s-ksattra/ESP32-P4-Motherboard/esp32-based-motherboard.pdf

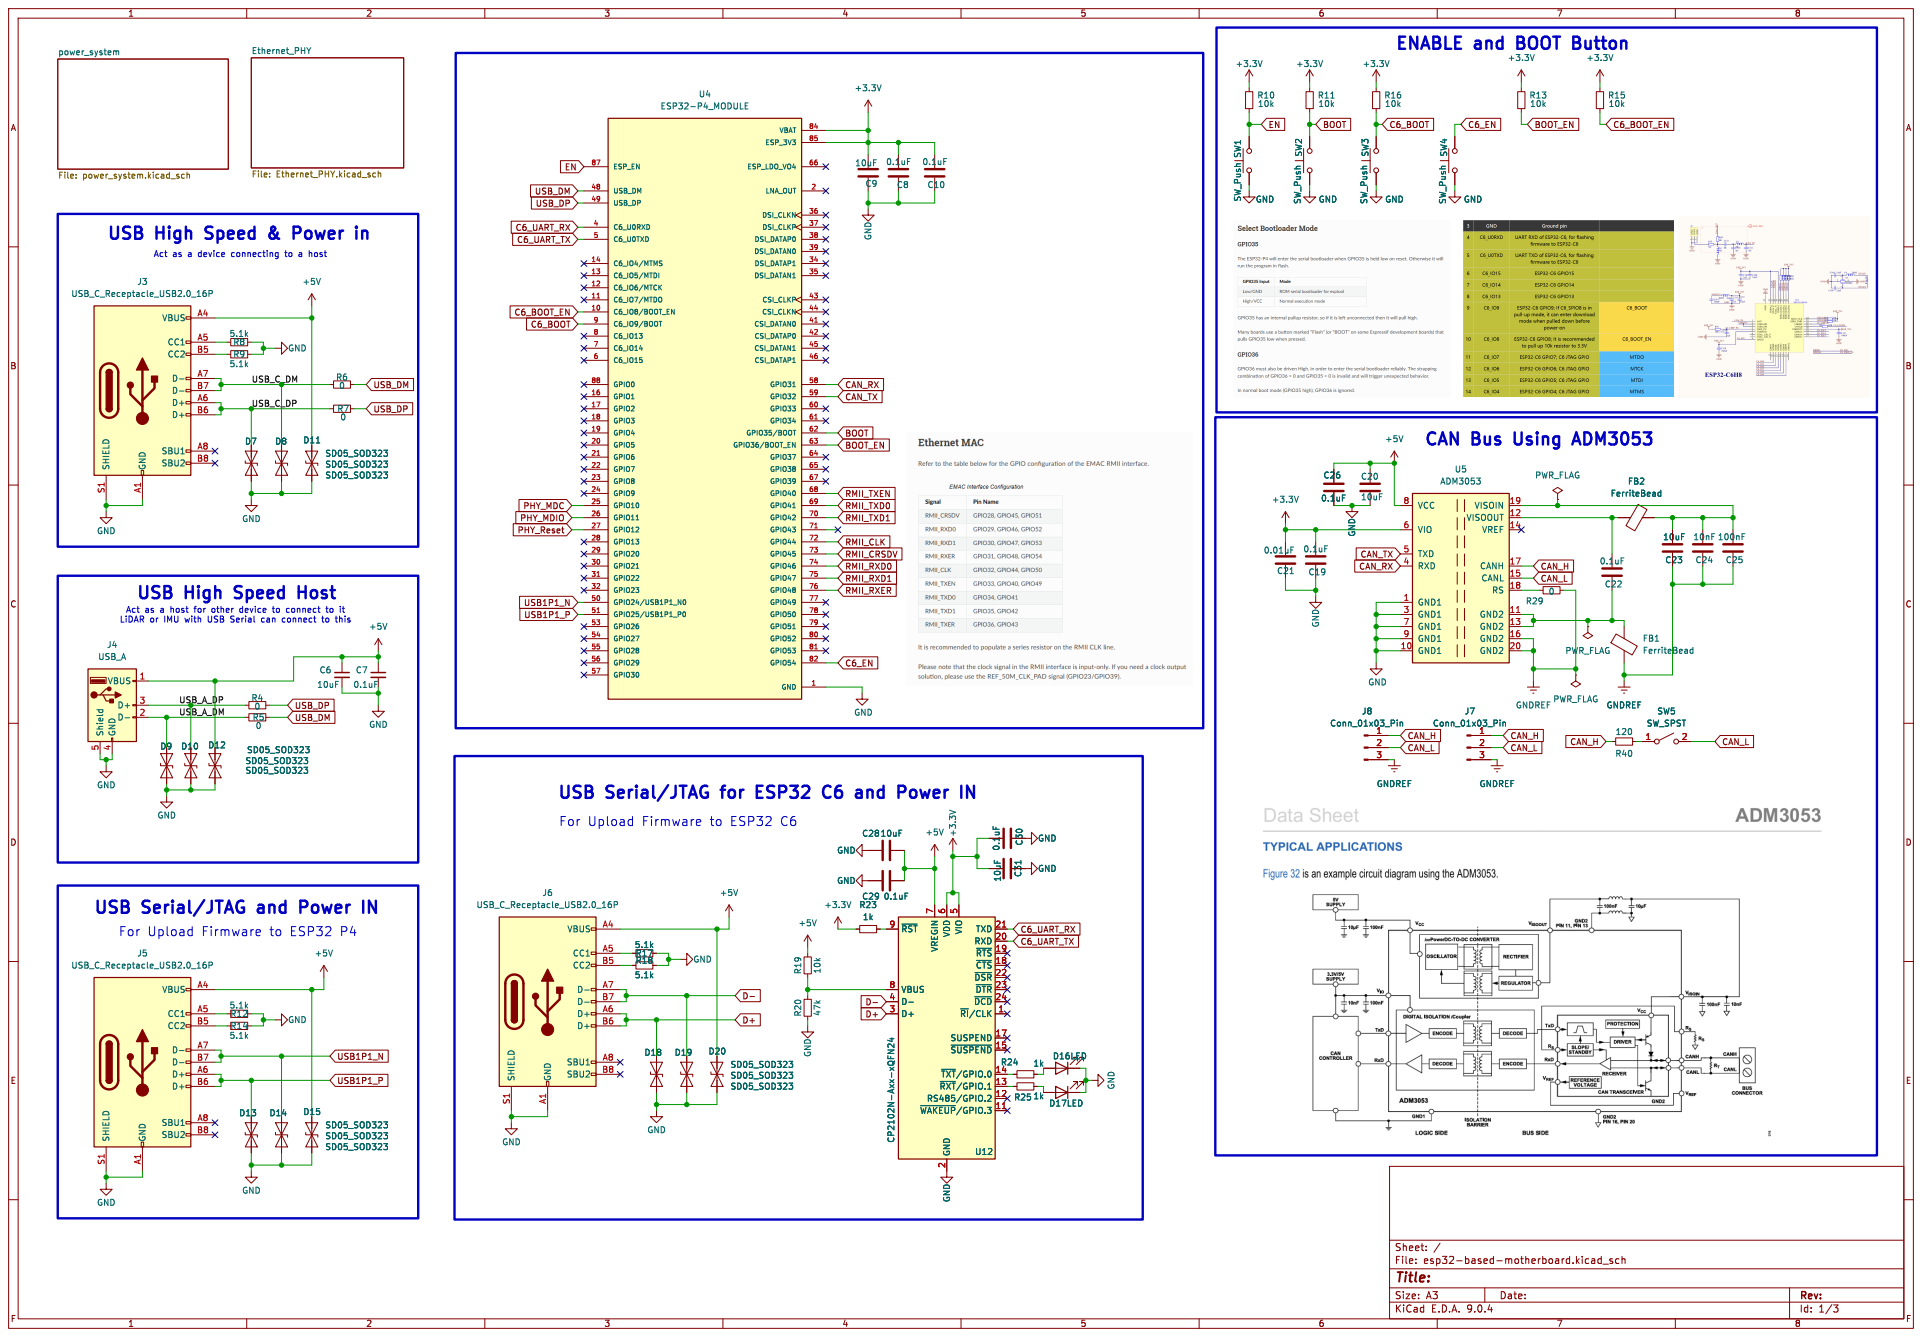
[picture p1: page 1]

ENABLE and BOOT Button

USB High Speed & Power in

For Upload Firmware to ESP32 C6

For Upload Firmware to ESP32 P4

Id: 1/3 Title: File: esp32-based-motherboard.kicad_sch Sheet: /

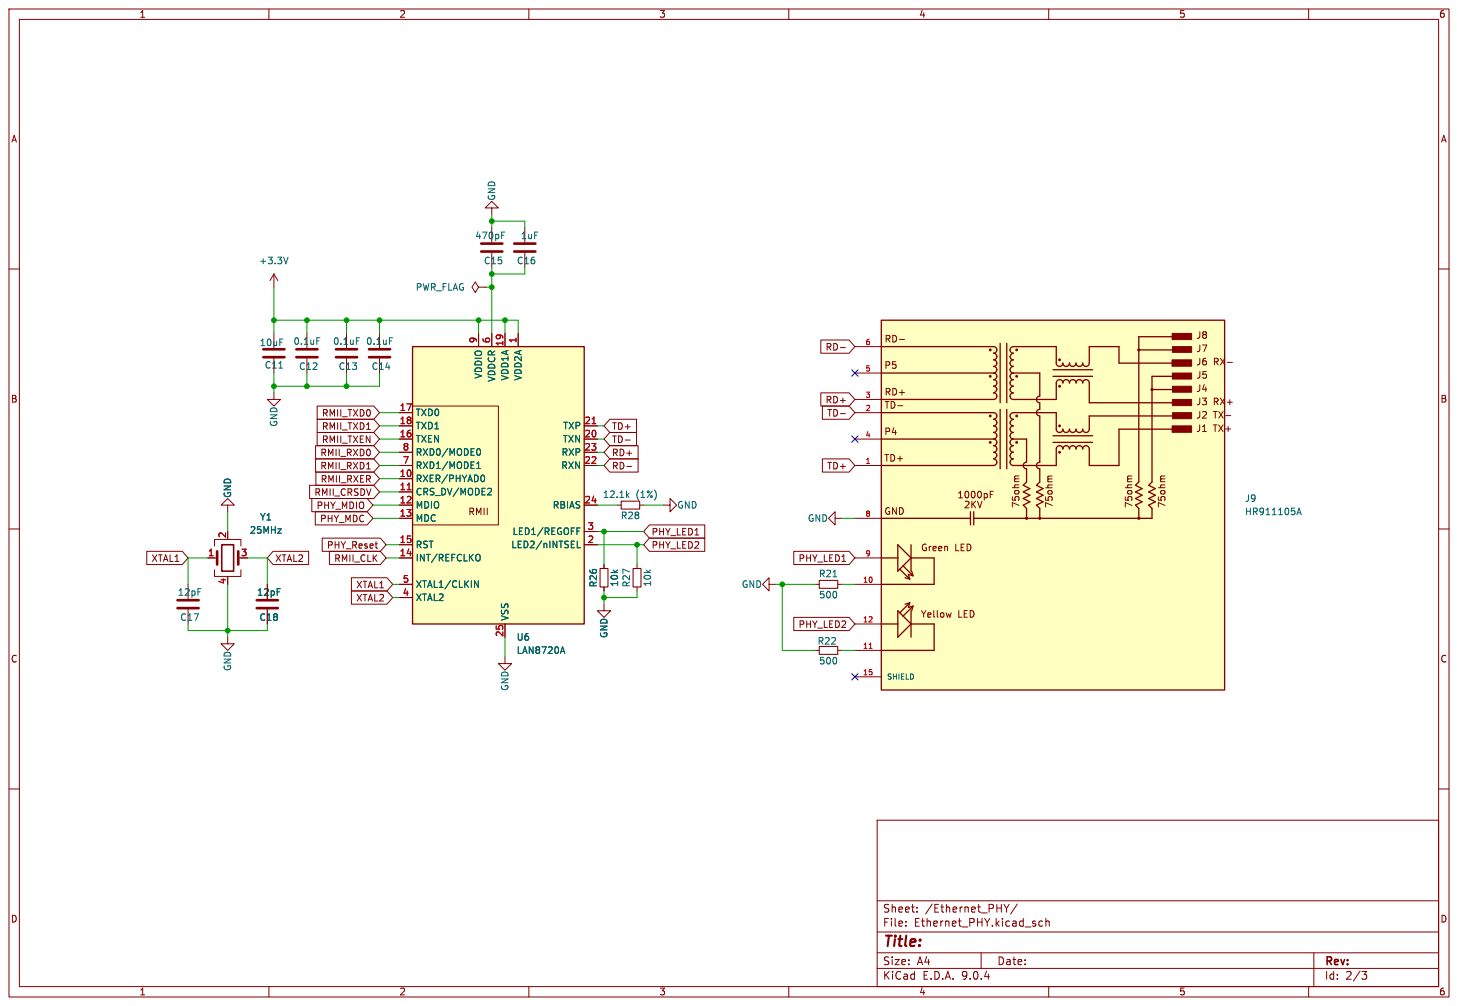
[picture p2: page 2]

1 TXP 21 TXN 20 RXP 23 RXN 22 RBIAS 24

Id: 2/3 Title: File: Ethernet_PHY.kicad_sch Sheet: /Ethernet_PHY/ C18

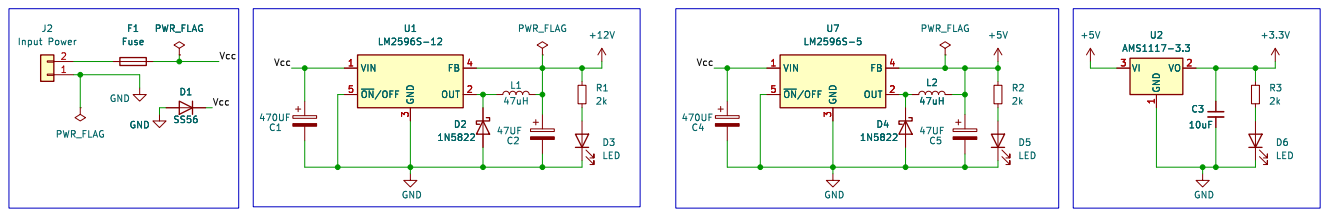
[picture p3: page 3]

1 VO 2 U2 AMS1117-3.3 Vcc Vcc Vcc Vcc F1 PWR_FLAG
Fuse GND

Id: 3/3 Title: File: power_system.kicad_sch Sheet: /power_system/
