s-ksattra/ESP32-P4-Motherboard/esp32-based-motherboard.kicad_pcb

## KiCad design esp32-based-motherboard.kicad_pcb (2026-08-06)

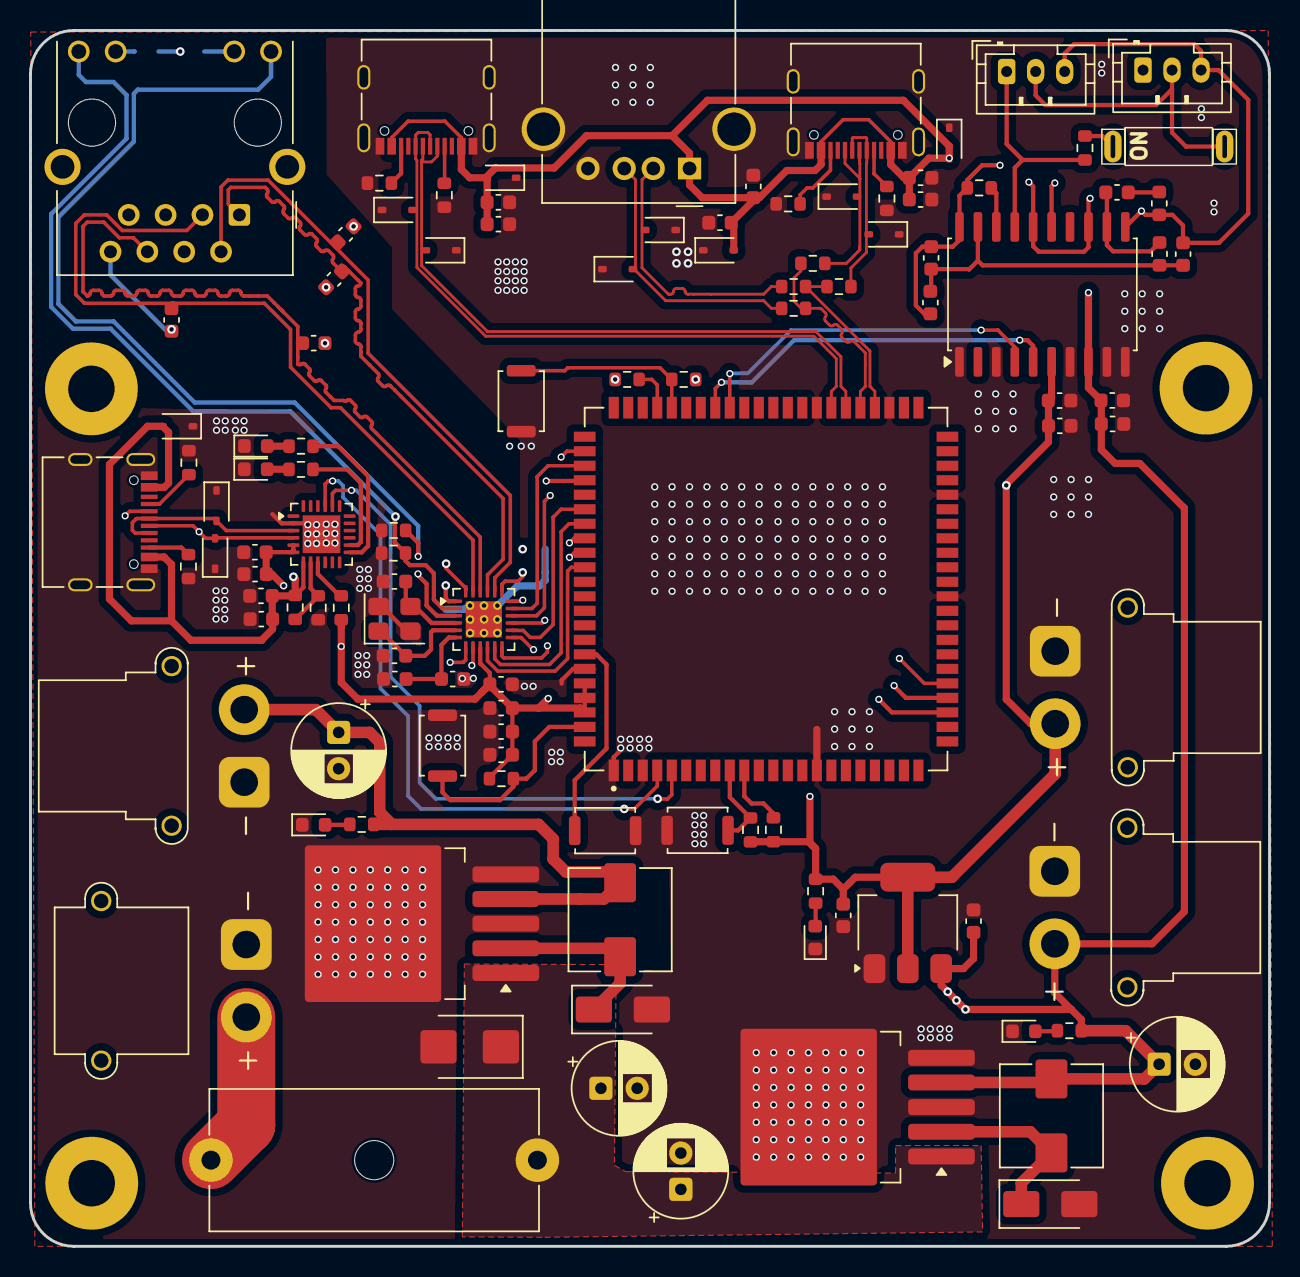
[picture p4: board esp32-based-motherboard.kicad_pcb from above]

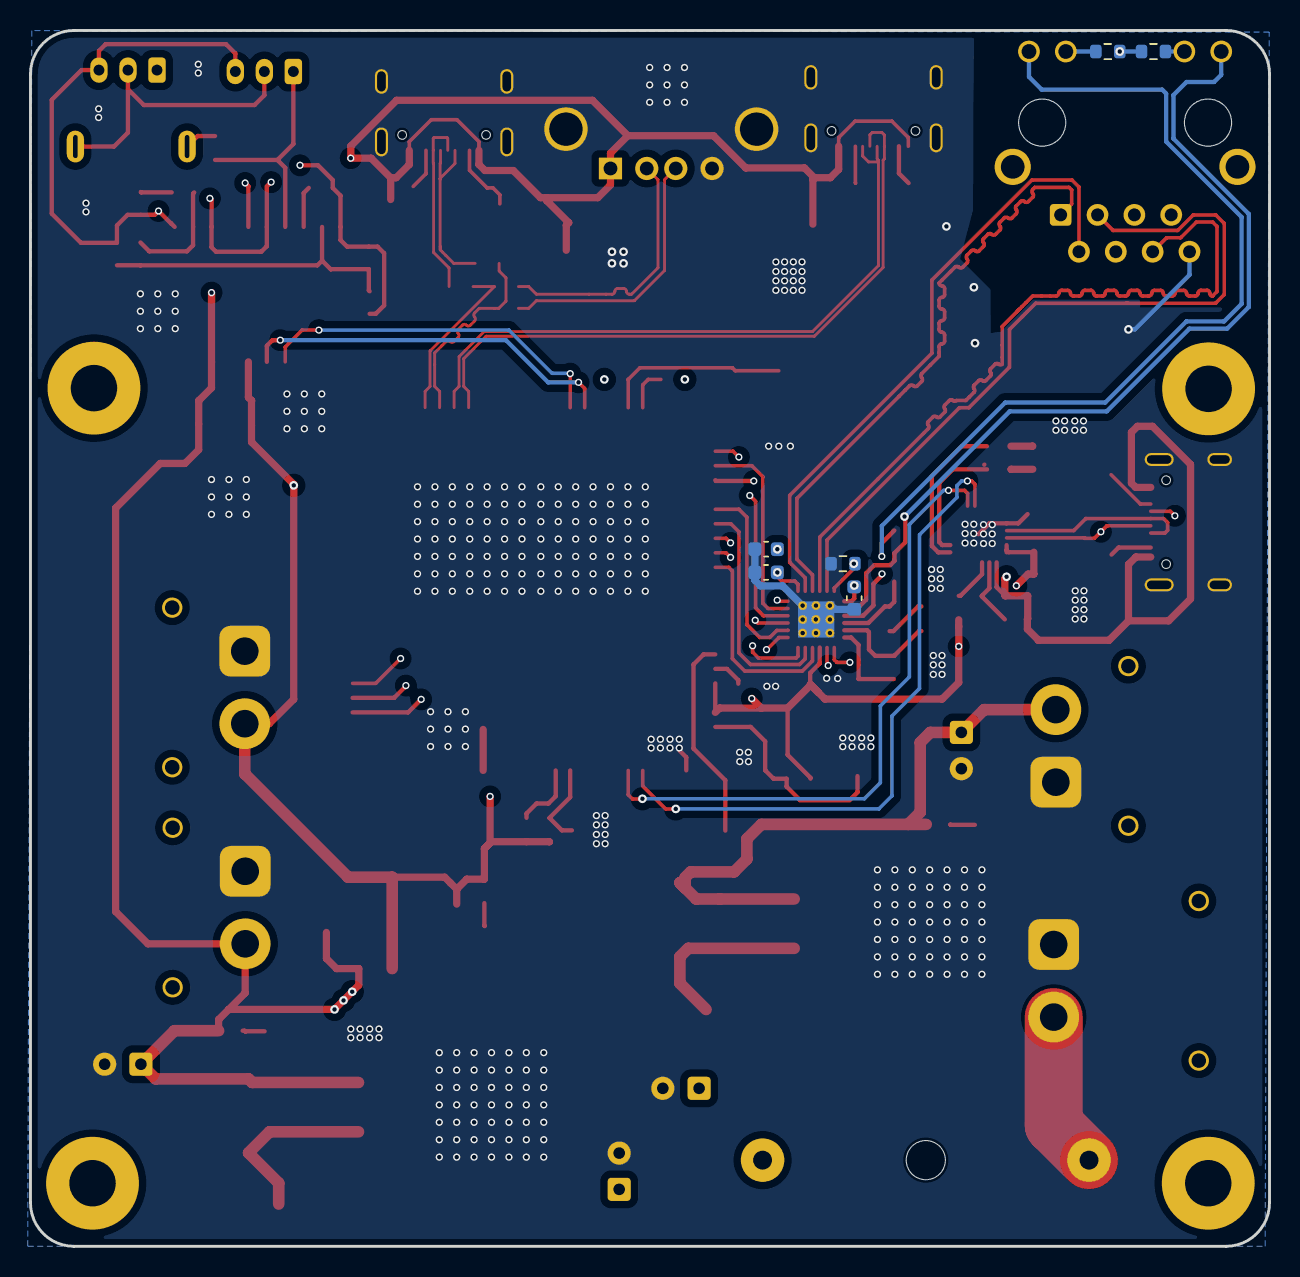
[picture p5: board esp32-based-motherboard.kicad_pcb from below]

Board: 4 copper layers, 85.4 x 83.8 mm, 122 parts (6 on the bottom side), 74 nets.

Parts:
C1, C3, C5, C9, C13, C15, C20, C30, C31, C32, C34: 10uF; C_0603_1608Metric
C2, C4, C6, C7, C8, C11, C12, C14, C21, C22, C23, C33, C35: 0.1uF; C_0603_1608Metric
C10: 0.01uF; C_0603_1608Metric
C16: 10nF; C_0603_1608Metric
C17: 100nF; C_0603_1608Metric
C18, C19, C36, C37, C38, C39: 12pF; C_0603_1608Metric
C24: 470pF; C_0603_1608Metric
C25: 1uF; C_0603_1608Metric
C26, C28: 470UF; CP_Radial_D6.3mm_P2.50mm
C27, C29: 47UF; CP_Radial_D6.3mm_P2.50mm
D1, D2, D3, D5, D7, D8, D9, D10, D11, D12: SD05C-01F; D_SOD-323
D4, D6: ESD7951ST5G; D_SOD-323
D13, D14, D17, D19, D20: LED; LED_0603_1608Metric
D15: SS56; D_SMB
D16, D18: 1N5822; D_SMA
F1: Fuse; Fuseholder_Cylinder-5x20mm_Schurter_0031_8201_Horizontal_Op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
FB1, FB2: FerriteBead; L_0603_1608Metric
H1, H2, H3, H4: MountingHole_Pad; MountingHole_3.2mm_M3_Pad
J1: USB_A; USB_A_Molex_67643_Horizontal
J2, J3, J4: USB_C_Receptacle_USB2.0_16P; USB_C_Receptacle_Palconn_UTC16-G
J5, J6: Conn_01x03_Pin; JST_PH_B3B-PH-K_1x03_P2.00mm_Vertical
J7: RJ45_Hanrun_HR911105A_Horizontal
J8: Conn_01x02_Pin; AMASS_XT30PW-M_1x02_P2.50mm_Horizontal
J9, J10, J11: Conn_01x02_Pin; AMASS_XT30PW-F_1x02_P2.50mm_Horizontal
L1, L2: 47uH; L_Wuerth_HCI-7030
R1, R2, R3, R4, R9, R10: 5.1k; R_0603_1608Metric
R5, R6, R7, R8, R20: 0; R_0603_1608Metric
R11, R16, R17, R18, R19, R21, R23, R25: 10k; R_0603_1608Metric
R12: 47k; R_0603_1608Metric
R13, R14, R15, R29: 1k; R_0603_1608Metric
R22: 120; R_0603_1608Metric
R24: 12.1k (1%); R_0603_1608Metric
R26, R27, R30: 500; R_0603_1608Metric
R28: 2k; R_0603_1608Metric
SW1, SW2, SW3, SW4: SW_Push; SW_Push_SPST_NO_Alps_SKRK
SW5: SW_SPST; DSIC01LHGET_C54957
U1: ESP32-P4_MODULE
U2: CP2102N-Axx-xQFN24; QFN-24-1EP_4x4mm_P0.5mm_EP2.6x2.6mm
U3: ADM3053; SOIC-20W_7.5x12.8mm_P1.27mm
U4: LAN8720A; VQFN-24-1EP_4x4mm_P0.5mm_EP2.5x2.5mm_ThermalVias
U5: LM2596S-12; TO-263-5_TabPin3
U6: LM2596S-5; TO-263-5_TabPin3
U7: AMS1117-3.3; SOT-223-3_TabPin2
Y1: 25MHz; Crystal_SMD_3225-4Pin_3.2x2.5mm

Connections:
+3.3V: C3.2, C4.2, C7.2, C8.2, C9.2, C10.2, C11.2, C20.2, C21.2, C22.2, C23.2, C30.1, J11.2, R13.2, R16.1, R17.1, R18.1, R19.1, R21.1, R30.1, U1.84 (VBAT), U1.85 (ESP_3V3), U1.86 (ESP_3V3), U2.5 (VIO), U2.6 (VDD), U3.6 (VIO), U4.1 (VDD2A), U4.9 (VDDIO), U4.19 (VDD1A), U7.2 (VO)
+5V: C1.1, C2.1, C5.2, C6.2, C12.1, C13.1, C29.1, C31.1, C32.1, C33.1, C34.1, C35.1, D3.2 (A2), D8.2 (A2), D9.2 (A2), D12.2 (A2), J1.1 (VBUS), J2.A4 (VBUS), J2.A9 (VBUS), J2.B4 (VBUS), J2.B9 (VBUS), J3.A4 (VBUS), J3.A9 (VBUS), J3.B4 (VBUS), J3.B9 (VBUS), J4.A4 (VBUS), J4.A9 (VBUS), J4.B4 (VBUS), J4.B9 (VBUS), J10.2, L2.2, R11.2, R29.1, U2.7 (VREGIN), U3.8 (VCC), U6.4 (FB), U7.3 (VI)
+12V: C27.1, J9.2, L1.2, R28.1, U5.4 (FB)
/USB_A_N: D1.2 (A2), J1.2 (D-), R6.1
/USB_A_P: D2.2 (A2), J1.3 (D+), R5.1
/USB_C_N: D6.2 (A2), J2.A7 (D-), J2.B7 (D-), R7.1
/USB_C_P: D4.2 (A2), J2.A6 (D+), J2.B6 (D+), R8.1
/power_system/Vcc: C26.1, C28.1, D15.1 (K), F1.2, U5.1 (VIN), U6.1 (VIN)
BOOT: R17.2, SW2.2, U1.62 (GPIO35/BOOT)
BOOT_EN: R19.2, U1.63 (GPIO36/BOOT_EN)
C6_BOOT: R18.2, SW3.2, U1.9 (C6_IO9/BOOT)
C6_BOOT_EN: R21.2, U1.10 (C6_IO8/BOOT_EN)
C6_EN: SW4.2, U1.82 (GPIO54)
C6_UART_RX: U1.4 (C6_U0RXD), U2.21 (TXD)
C6_UART_TX: U1.5 (C6_U0TXD), U2.20 (RXD)
CAN_H: J5.1, J6.1, R22.2, U3.17 (CANH)
CAN_L: J5.2, J6.2, SW5.2 (B), U3.15 (CANL)
CAN_RX: U1.58 (GPIO31), U3.4 (RXD)
CAN_TX: U1.59 (GPIO32), U3.5 (TXD)
D+: D10.2 (A2), J4.A6 (D+), J4.B6 (D+), U2.3 (D+)
D-: D11.2 (A2), J4.A7 (D-), J4.B7 (D-), U2.4 (D-)
EN: R16.2, SW1.2, U1.87 (ESP_EN)
ETH_RD+: C39.2, J7.3 (RD+), U4.23 (RXP)
ETH_RD-: C38.2, J7.6 (RD-), U4.22 (RXN)
ETH_TD+: C36.2, J7.1 (TD+), U4.21 (TXP)
ETH_TD-: C37.2, J7.2 (TD-), U4.20 (TXN)
GND: C1.2, C2.2, C3.1, C4.1, C5.1, C6.1, C7.1, C8.1, C9.1, C10.1, C11.1, C12.2, C13.2, C18.1, C19.1, C20.1, C21.1, C22.1, C23.1, C24.2, C25.2, C26.2, C27.2, C28.2, C29.2, C30.2, C31.2, C32.2, C33.2, C34.2, C35.2, C36.1, C37.1, C38.1, C39.1, D1.1 (A1), D2.1 (A1), D3.1 (A1), D4.1 (A1), D5.1 (A1), D6.1 (A1), D7.1 (A1), D8.1 (A1), D9.1 (A1), D10.1 (A1), D11.1 (A1), D12.1 (A1), D13.1 (K), D14.1 (K), D15.2 (A), D16.2 (A), D17.1 (K), D18.2 (A), D19.1 (K), D20.1 (K), J1.4 (GND), J1.5 (Shield), J2.A1 (GND), J2.A12 (GND), J2.B1 (GND), J2.B12 (GND), J2.S1 (SHIELD), J3.A1 (GND), J3.A12 (GND), J3.B1 (GND), J3.B12 (GND), J3.S1 (SHIELD), J4.A1 (GND), J4.A12 (GND), J4.B1 (GND), J4.B12 (GND), J4.S1 (SHIELD), J7.8, J8.1, J9.1, J10.1, J11.1, R1.2, R2.2, R3.2, R4.2, R9.2, R10.2, R12.1, R23.2, R24.2, R25.2, R26.1, R27.1, SW1.1, SW2.1, SW3.1, SW4.1, U1.1 (GND), U1.3 (GND), U1.15 (GND), U1.33 (GND), U1.40 (GND), U1.47 (GND), U1.52 (GND), U1.83 (GND), U2.2 (GND), U2.25 (GND), U3.1 (GND1), U3.3 (GND1), U3.7 (GND1), U3.9 (GND1), U3.10 (GND1), U4.25 (VSS), U5.3 (GND), U5.5 (~ON/OFF), U6.3 (GND), U6.5 (~ON/OFF), U7.1 (GND), Y1.2 (G), Y1.4 (G)
GNDREF: C15.1, C16.1, C17.1, FB1.2, J5.3, J6.3, R20.1, U3.11 (GND2), U3.13 (GND2), U3.16 (GND2), U3.20 (GND2)
unnamed: C14.1, FB1.1
unnamed: D13.2 (A), R14.1
unnamed: D14.2 (A), R15.1
unnamed: D16.1 (K), L1.1, U5.2 (OUT)
unnamed: D17.2 (A), R28.2
unnamed: D18.1 (K), L2.1, U6.2 (OUT)
unnamed: D19.2 (A), R29.2
unnamed: D20.2 (A), R30.2
unnamed: J2.A5 (CC1), R1.1
unnamed: J2.B5 (CC2), R2.1
unnamed: J3.A5 (CC1), R3.1
unnamed: J3.B5 (CC2), R4.1
unnamed: J4.A5 (CC1), R9.1
unnamed: J4.B5 (CC2), R10.1
unnamed: J7.10, R27.2
unnamed: J7.11, R26.2
unnamed: F1.1, J8.2
unnamed: R22.1, SW5.1 (A)
unnamed: R11.1, R12.2, U2.8 (VBUS)
unnamed: R13.1, U2.9 (~RST)
unnamed: R15.2, U2.13 (~RXT/GPIO.1)
unnamed: R14.2, U2.14 (~TXT/GPIO.0)
unnamed: R20.2, U3.18 (RS)
unnamed: C15.2, C16.2, C17.2, FB2.1, U3.19 (VISOIN)
unnamed: C14.2, FB2.2, U3.12 (VISOOUT)
unnamed: R24.1, U4.24 (RBIAS)
unnamed: C24.1, C25.1, U4.6 (VDDCR)
PHY_LED1: J7.9, R25.1, U4.3 (LED1/REGOFF)
PHY_LED2: J7.12, R23.1, U4.2 (LED2/~INTSEL)
PHY_MDC: U1.25 (GPIO10), U4.13 (MDC)
PHY_MDIO: U1.26 (GPIO11), U4.12 (MDIO)
PHY_Reset: U1.27 (GPIO12), U4.15 (~RST)
RMII_CLK: U1.72 (GPIO44), U4.14 (~INT/REFCLKO)
RMII_CRSDV: U1.73 (GPIO45), U4.11 (CRS_DV/MODE2)
RMII_RXD0: U1.74 (GPIO46), U4.8 (RXD0/MODE0)
RMII_RXD1: U1.75 (GPIO47), U4.7 (RXD1/MODE1)
RMII_RXER: U1.76 (GPIO48), U4.10 (RXER/PHYAD0)
RMII_TXD0: U1.69 (GPIO41), U4.17 (TXD0)
RMII_TXD1: U1.70 (GPIO42), U4.18 (TXD1)
RMII_TXEN: U1.68 (GPIO40), U4.16 (TXEN)
USB1P1_N: D7.2 (A2), J3.A7 (D-), J3.B7 (D-), U1.50 (GPIO24/USB1P1_N0)
USB1P1_P: D5.2 (A2), J3.A6 (D+), J3.B6 (D+), U1.51 (GPIO25/USB1P1_P0)
USBHS_N: R6.2, R7.2, U1.48 (USB_DM)
USBHS_P: R5.2, R8.2, U1.49 (USB_DP)
XTAL1: C18.2, U4.5 (XTAL1/CLKIN), Y1.1
XTAL2: C19.2, U4.4 (XTAL2), Y1.3
