s-ksattra/ESP32-P4-Motherboard/(commit log)

2026-07-27 Add KiCad custom library as submodule
    [ESP32_P4_Module.kicad_sch, Ethernet_PHY.kicad_sch, Power_System.kicad_sch, esp32-based-motherboard.kicad_pcb, esp32-based-motherboard.kicad_sch]
2026-08-04 Updated footprint
    [Ethernet_PHY.kicad_sch, Power_System.kicad_sch, esp32-based-motherboard.kicad_sch]
2026-08-04 Finalized schematics V1
    [Ethernet_PHY.kicad_sch, Power_System.kicad_sch, esp32-based-motherboard.kicad_pcb, esp32-based-motherboard.kicad_sch]
2026-08-04 Updated PCB Layout
2026-08-05 Track and Vias added
    [Ethernet_PHY.kicad_sch, esp32-based-motherboard.kicad_pcb, esp32-based-motherboard.kicad_sch]
